Open-Lab-Starter-Kit/OLSK-3D-Scanner/OLSK_3D_Scanner_V2/CAD-Workshop/README.md

CAD file for the Workshop at Motion Lab Berlin on the 10th October 2024.
