Open-Lab-Starter-Kit/OLSK-3D-Scanner/OLSK_3D_Scanner_V2/media/OLSK_3D_Scanner_V2.png

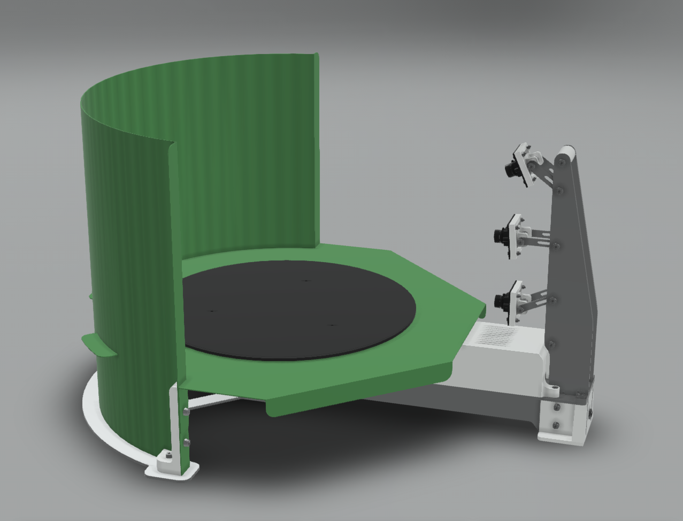
OLSK_3D_Scanner_V2/media/OLSK_3D_Scanner_V2.png
