Open-Lab-Starter-Kit/OLSK-3D-Scanner/OLSK 3D Scanner V3 - BOM.xlsx

Part Name | Amount
Arc Base Connector A | 1
Arc Base Connector B | 1
Arc Bottom Structure | 1
Arc Middle Structure | 1
Arc Plate | 1
Arc Top Connector | 1
Arc Top Structure | 1
Back Left Spacer | 2
Back Right Spacer | 2
Base Plate | 1
Base Side Plate Right | 1
Bottom Cover | 1
Camera Back Holder | 1
Camera Front Holder | 1
Camera Module Arducam B0290 | 1
Center Spacer | 3
Chain | 1
Electronic Panel | 1
Electronic Panel Spacer | 6
Fixed Background Back | 1
Fixed Background Side | 2
Front Left Spacer | 2
Front Right Spacer | 1
Front Right Spcer | 1
Handle | 1
Handle Magnet | 4
Head Bearing | 3
Head Chain Holder | 1
Head Endstop Sensor | 1
Head Left Plate | 1
Head Magnet | 1
Head Motor | 1
Head Right Plate | 1
Head Spacer 12 | 3
Head Spacer 8 | 3
Head Thumbscrew | 1
LED Bar | 2
LED Bar Holder | 4
LED GND Cable | 1
LED Ring | 1
LED Ring Holder | 1
LED SIG Cable | 1
Light Diffuser Plate | 1
Lock Nut M3 | 5
Main Board | 1
Main Board (+) Cable | 1
Main Board (-) Cable | 1
Motor Drive | 2
Motor Spacer
Nylon Nut M3 | 1
Plastic Screw M3-10 | 1
Plastic Screw M3-6 | 12
Plastic Screw M3-8 | 4
Power (+) Cable | 1
Power (-) Cable | 1
Power Cable Jack | 1
Power Jumper Cable | 1
Power Switch | 1
Rubber Foot | 6
Set screw M5 | 2
Side Plate | 3
Sliding Background | 1
Snap Fit Button F | 8
Snap Fit Button M | 8
Spur Gear | 1
Spur Gear Support | 1
Standoff F M3-15 | 8
Threaded Pipe | 4
Top Center Front Spacer | 1
Top Cover | 1
Top Plate | 1
Turning Table Bearing | 1
Turning Table Internal Gear | 1
Turning Table Motor | 1
Turning Table Plate | 1
Turning Table Plate Spacer | 12
Turning Table Side Cover | 6
Turning Table Spacer | 6
USB Cable Inside | 1
Voltage Converter | 1
Voltage Converter Holder | 1
Voltage Converter IN+ Cable | 1
Voltage Converter IN- Cable | 1
Voltage Converter OUT+ Cable | 1
Voltage Converter OUT- Cable | 1
Washer M3 | 1
Washer M5 Large | 4
Wire Connector | 6
Fasteners
DIN 7991 M3-16 | 2
DIN 7991 M3-20 | 2
DIN 7991 M4-8 | 1
DIN 912 M2.5-16 | 4
DIN 912 M5-10 | 3
DIN 912 M5-14 | 2
DIN 912 M8-20 | 6
ISO 7380 M12-20 | 8
ISO 7380 M3-12 | 2
ISO 7380 M3-16 | 4
ISO 7380 M3-30 | 2
ISO 7380 M3-35 | 3
ISO 7380 M3-6 | 2
ISO 7380 M5-10 | 6
ISO 7380 M5-12 | 25
ISO 7380 M5-16 | 6
ISO 7380 M5-20 | 10
ISO 7380 M5-30 | 12
ISO 7380 M5-35 | 5
ISO 7380 M5-40 | 2
ISO 7380 M5-8 | 2
ISO 7380 M8-12 | 26
