Open-Lab-Starter-Kit/OLSK-3D-Scanner/OLSK_3D_Scanner_V2/BOM/BOM_ OLSK_3D_Scanner_v2.xlsx

BOM: OLSK 3D Scanner v2
Quantity | Part Name
 | Frame
1 | Base (3mm Fiber Lasercut Aluminum)
1 | Plater Holder (20mm Milled Aluminum)
1 | Plater (3mm Fiber Lasercut Aluminum)
2 | Vertical Side (3mm Fiber Lasercut Aluminum)
2 | Horizontal Side (3mm Fiber Lasercut Aluminum)
1 | Back Retainer (3mm Fiber Lasercut Aluminum)
6 | Camera Module Arm (3mm Fiber Lasercut Aluminum)
2 | Spacer (3D printed with M4 inserts)
1 | Front Cover (3D printed)
1 | Bottom Cover (3D printed)
 | Background structure
1 | Horizontal panel (0,80mm Lasercut Polypropilene)
1 | Vertical panel (0,80mm Lasercut Polypropilene)
1 | Bottom base (3mm Fiber Lasercut Aluminum)
2 | Background holders (3D printed)
 | Mechanics
2 | Bearing KFL08
1 | GT2 10mm Closed Loop Belt 215 teeth
2 | GT2 36T W10 Pulley
1 | 8mm Shaft x 90mm
 | Electronics
1 | Stepper Motor Nema 17 - 7HS15-1504S-X1
3 | IMX179 Autofocus USB Cameras
3 | USB to JST connector cable - Included with camera module
3 | Camera Module Holder (3D printed)
1 | ESP8266 NodeMCU Board
1 | OLSK 3D Scanner Board
1 | Electronics Cover - bigger section (3D printed)
1 | Electronics Cover - smaller section (3D printed)
1 | Stepper Motor Driver - DRV8825
1 | Stepper Motor Cable - 4x26AWG with 2.5 pitch female JST connector 15cm
1 | PSU to DC-DC Module Cable - 2x26AWG 10cm
1 | Micro USB to USB cable - 90° connector
1 | USB HUB 3.0 - 4 ports
1 | USB HUB holder (3D printed)
 | Fasteners
12 | C Screw DIN912 M2 x 12mm
4 | C Screw DIN912 M3 x 8mm
3 | C Screw DIN912 M4 x 6mm
2 | C Screw DIN912 M4 x 8mm
12 | C Screw DIN912 M4 x 10mm
16 | C Screw DIN912 M4 x 12mm
8 | C Screw DIN912 M4 x 16mm
2 | Set Screw ISO4026 M5 x 8mm
5 | Nylon Scew M3 x 6mm
2 | Nylon hex nut M3
3 | PCB spacer M3 x 6mm
12 | Locknut DIN985 M2
12 | Locknut DIN985 M4
