Open-Lab-Starter-Kit/OLSK-3D-Scanner/OLSK_3D_Scanner_V3_WiringSchematic.pdf

# OLSK 3D SCANNER V1

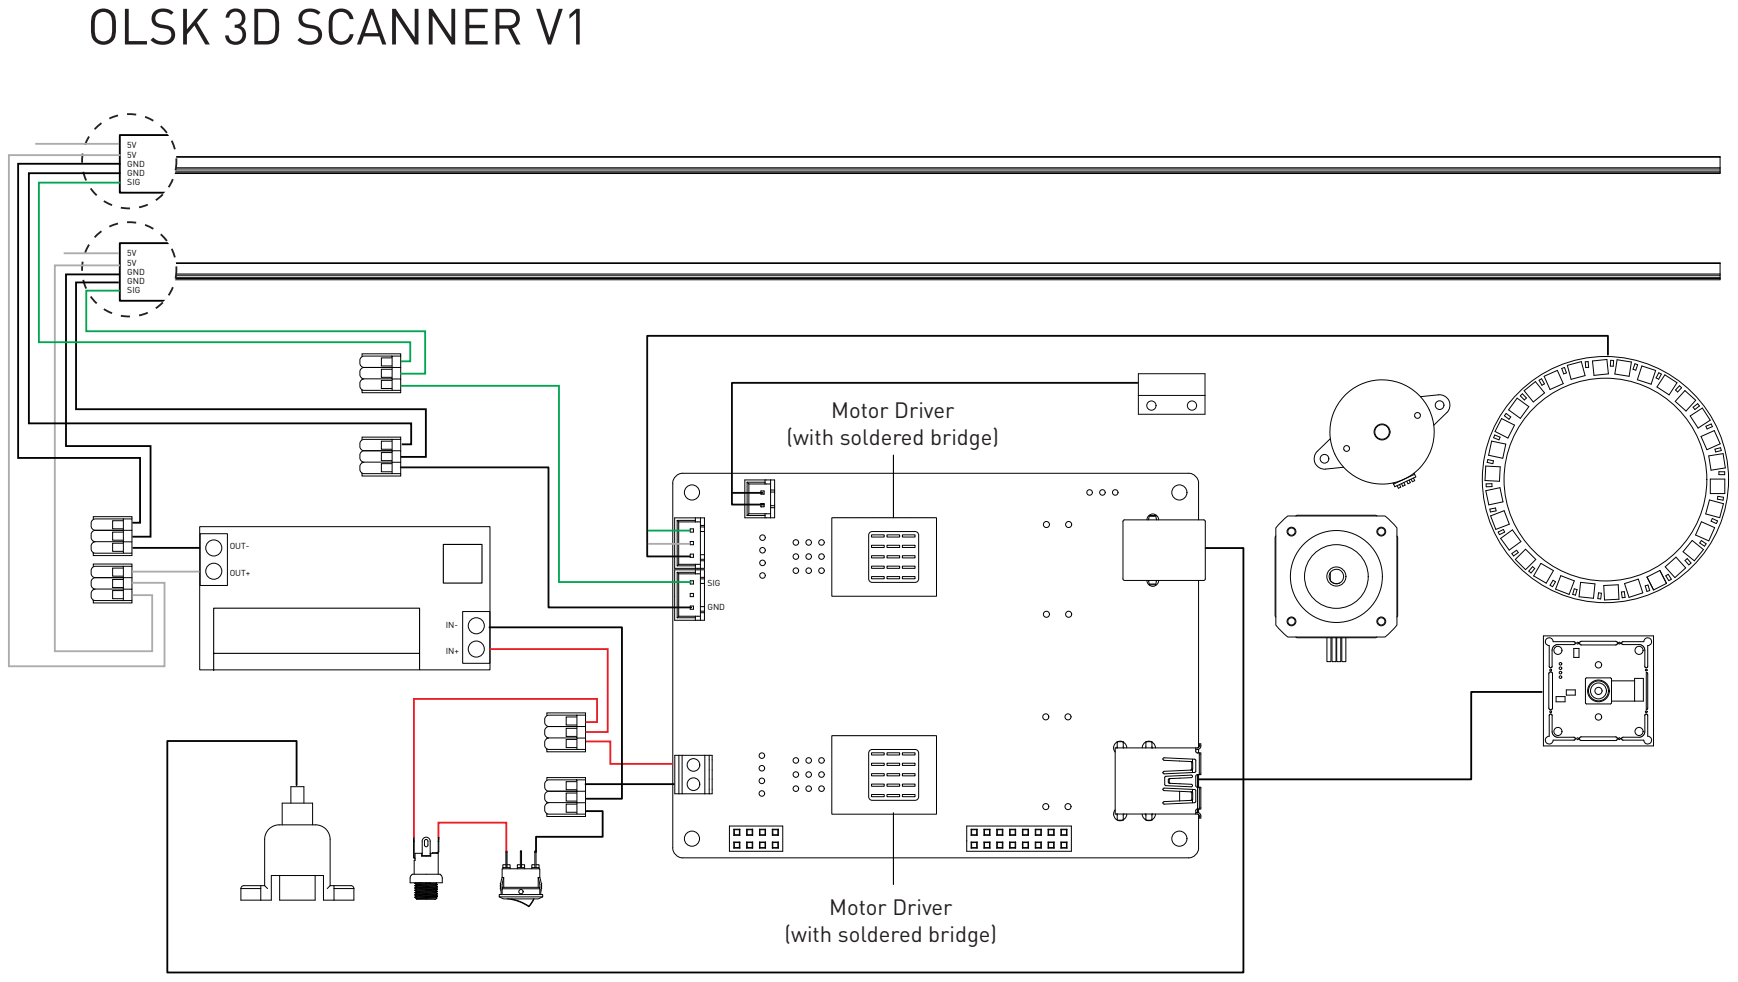
[picture p10: page 1]
OUT+; OUT-; GND; SIG

Motor Driver
(with soldered bridge)
