Open-Lab-Starter-Kit/OLSK-3D-Scanner/OLSK_3D_Scanner_V2/3D_Scanner_V2_WiringSchematic.pdf

# OLSK 3D SCANNER V2

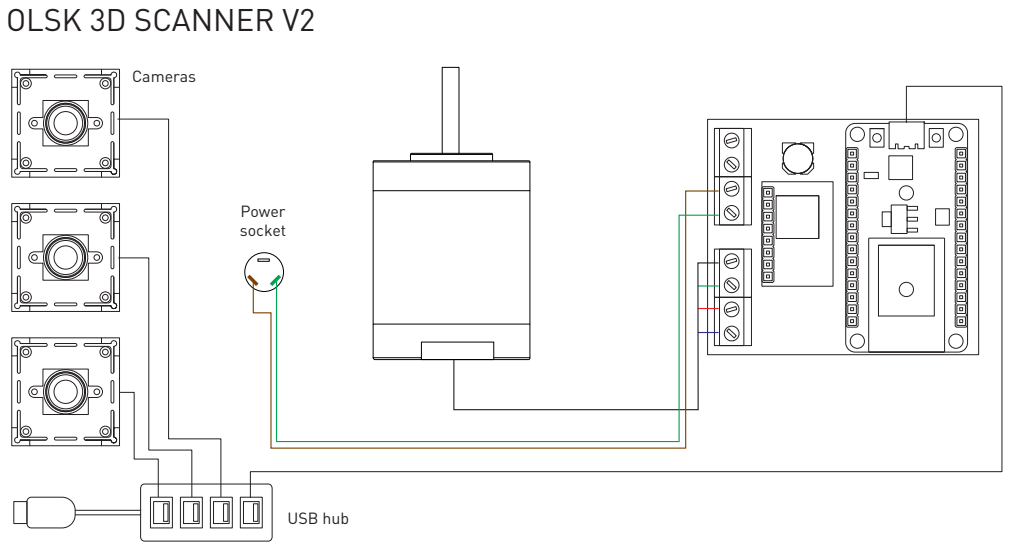
[picture p11: page 1]
Power socket; Cameras; USB hub
