Open-Lab-Starter-Kit/OLSK-3D-Scanner/OLSK_3D_Scanner_V2/OLSK_3D_Scanner_V2_Workbook.pdf

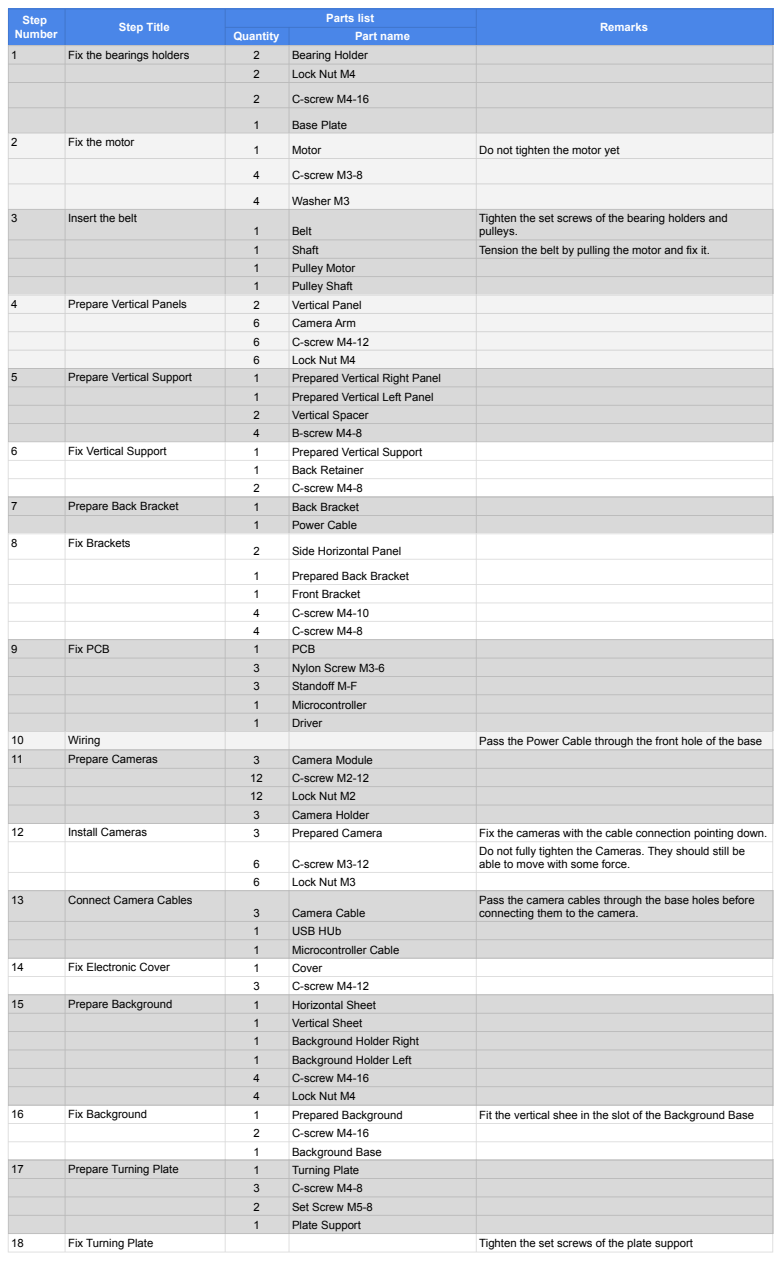
[picture p12: page 1]
Step; Number; Step Title; Parts list; Remarks; Quantity; Part name; Fix the bearings holders; Bearing Holder; Lock Nut M4; C-screw M4-16; Base Plate; Fix the motor; Motor; Do not tighten the motor yet; C-screw M3-8; Washer M3; Insert the belt; Belt; Shaft; Tension the belt by pulling the motor and fix it.; Pulley Motor; Pulley Shaft; Prepare Vertical Panels; Vertical Panel; Camera Arm; C-screw M4-12; Prepare Vertical Support; Prepared Vertical Right Panel; Prepared Vertical Left Panel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

Tighten the set screws of the bearing holders and
pulleys.

Do not fully tighten the Cameras. They should still be
able to move with some force.

Pass the camera cables through the base holes before
connecting them to the camera.
