Open-Lab-Starter-Kit/OLSK-3D-Scanner/OLSK_3D_Scanner_V2/PCB/Schematic_nodemcu_stepper_2023-12-21.pdf

## NodeMCU

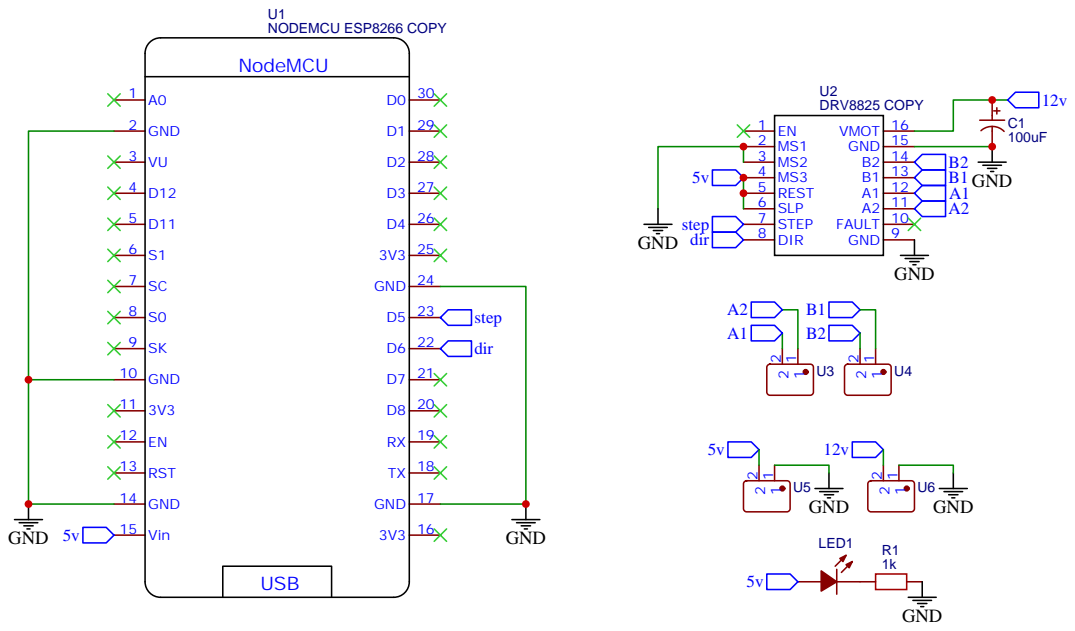
[picture p13: page 1]

Company: InMachines Ingrassia GmbH

Drawn By: Wilhelm Sch tze
