Open-Lab-Starter-Kit/OLSK-3D-Scanner/OLSK_3D_Scanner_V2/PCB/PCB_PCB_nodemcu_stepper_2023-12-21.pdf

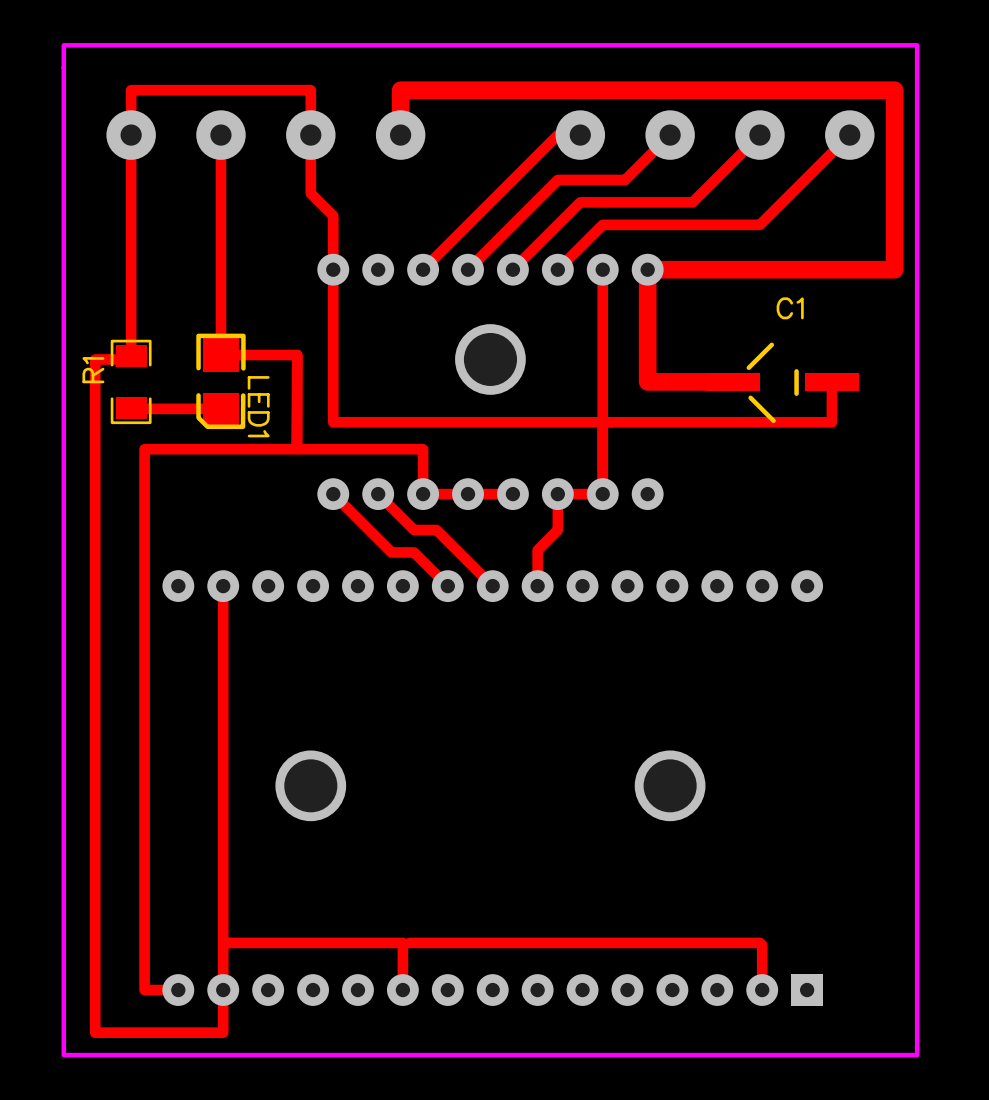
[picture p14: page 1]
