Open-Lab-Starter-Kit/OLSK-3D-Scanner/OLSK_3D_Scanner_V1/3D_Scanner_V1_WiringSchematic.pdf

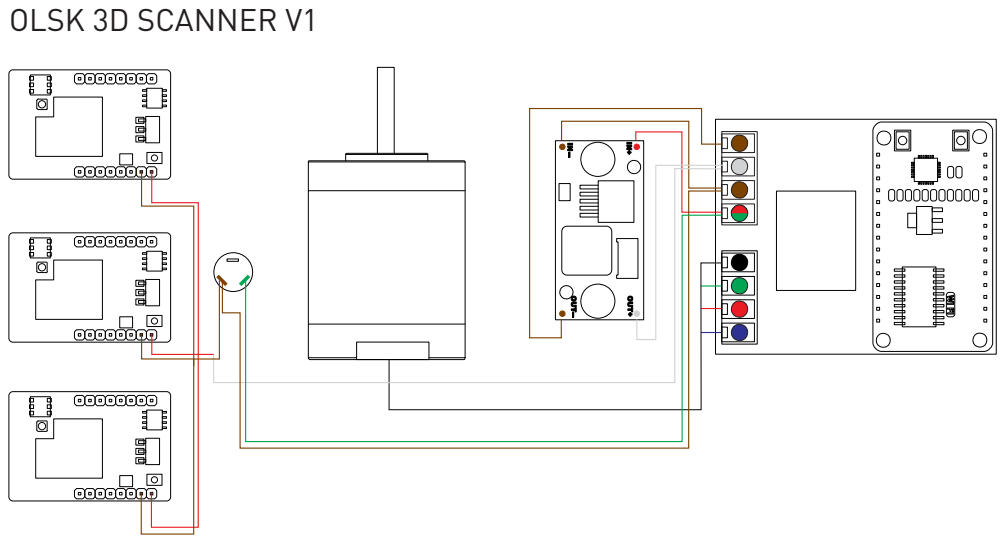
[picture p15: page 1]
OLSK 3D SCANNER V1
