Open-Lab-Starter-Kit/OLSK-3D-Scanner/(list of files, drawings)

Other design files:
OLSK_3D_Scanner_V2/PCB/PCB_PCB_nodemcu_stepper_2023-12-21.json
OLSK_3D_Scanner_V2/PCB/SCH_nodemcu_stepper_2023-12-21.json
