Open-Lab-Starter-Kit/OLSK-3D-Scanner/(commit log)

2022-12-24 added cad files
2023-03-30 added BOM
    [OLSK 3D Scanner V1 BOM.ods, OLSK 3D Scanner V1 BOM.xlsx]
2023-12-20 update v2
    [BOM_ OLSK_3D_Scanner_v2.xlsx]
2023-12-21 update pcb
    [PCB_PCB_nodemcu_stepper_2023-12-21.json, SCH_nodemcu_stepper_2023-12-21.json]
2024-10-17 Revert "Added 3D Scanner V3 source code"
    This reverts commit 52ec4e1220d69f5f05d035a288974c2e124503c7.
    [ScannerMiddle.ino, Triceratops.py, esp32MainBoardAcc.ino]
2025-02-28 Revert "Added separate RGB settings for side and ring settings"
    This reverts commit a97b7b15365f71bd5c20b214e447f569bcd95f28.
    [ScannerMiddle.ino]
2025-03-13 Update Aseembly Manual
    [BOM_ OLSK_3D_Scanner_v2.xlsx, PCB_PCB_nodemcu_stepper_2023-12-21.json, SCH_nodemcu_stepper_2023-12-21.json]
2025-03-17 Upload cad
2025-03-19 Update Assembly Manual
2025-12-03 Delete OLSK_3D_Scanner_V3-BOM.xlsx
    Remove BOM for update
    [OLSK_3D_Scanner_V3-BOM.xlsx]
2025-12-03 Add files via upload
    updated BOM
    [OLSK 3D Scanner V3 - BOM.xlsx]
